heynevets/Smarker/Arduino/COEN315Assignment2/WebTrial/background.jpg

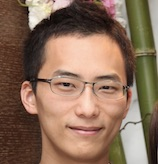
Arduino/COEN315Assignment2/WebTrial/background.jpg
