heynevets/Smarker/1_Deliverables/4_OutputSamples/2_Website/Screen Shot 2019-03-21 at 12.37.06 AM.png

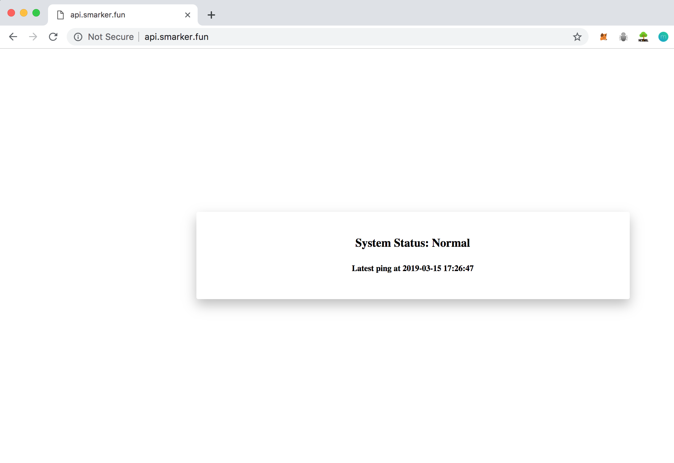
1_Deliverables/4_OutputSamples/2_Website/Screen Shot 2019-03-21 at 12.37.06 AM.png
