heynevets/Smarker/1_Deliverables/5_Reference/3_Propoganda/pamphlet.png

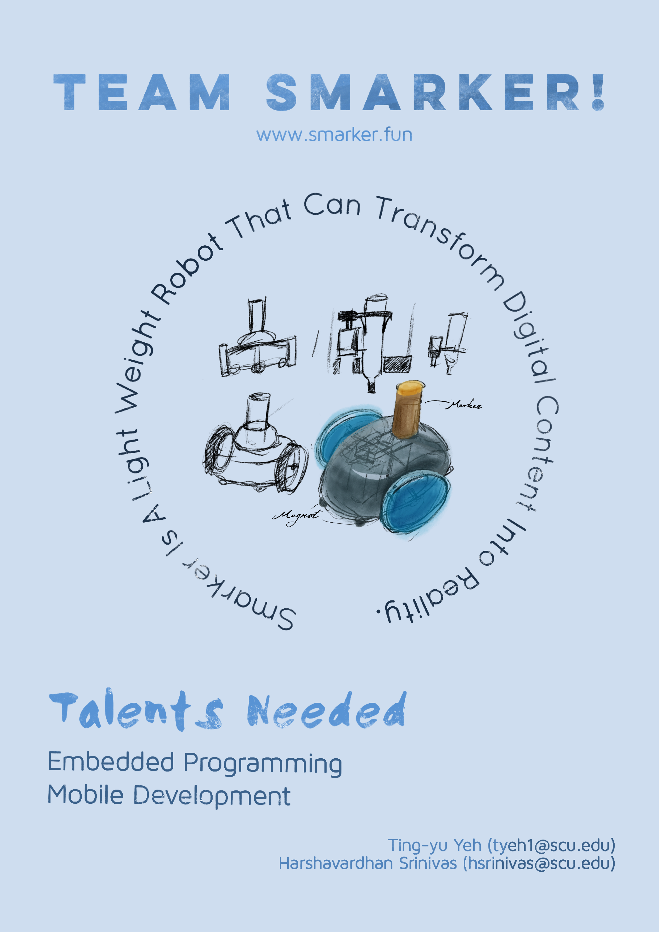
1_Deliverables/5_Reference/3_Propoganda/pamphlet.png
