heynevets/Smarker/Arduino/COEN315Assignment2/WebTrial/IMG_0066.png

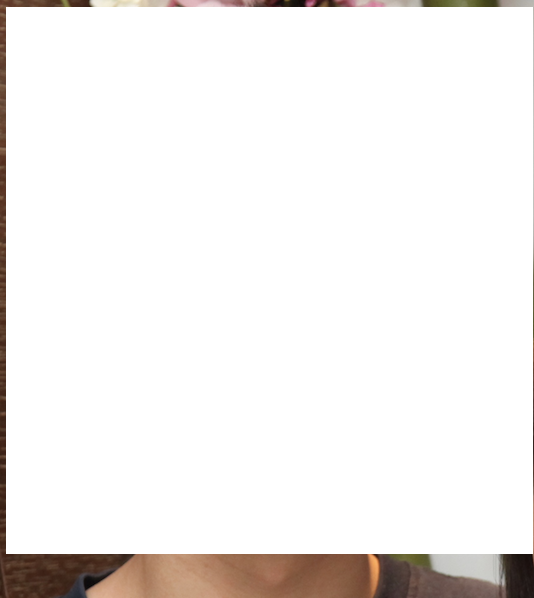
Arduino/COEN315Assignment2/WebTrial/IMG_0066.png
