heynevets/Smarker/1_Deliverables/5_Reference/1_CAD/WheelOuter.stl

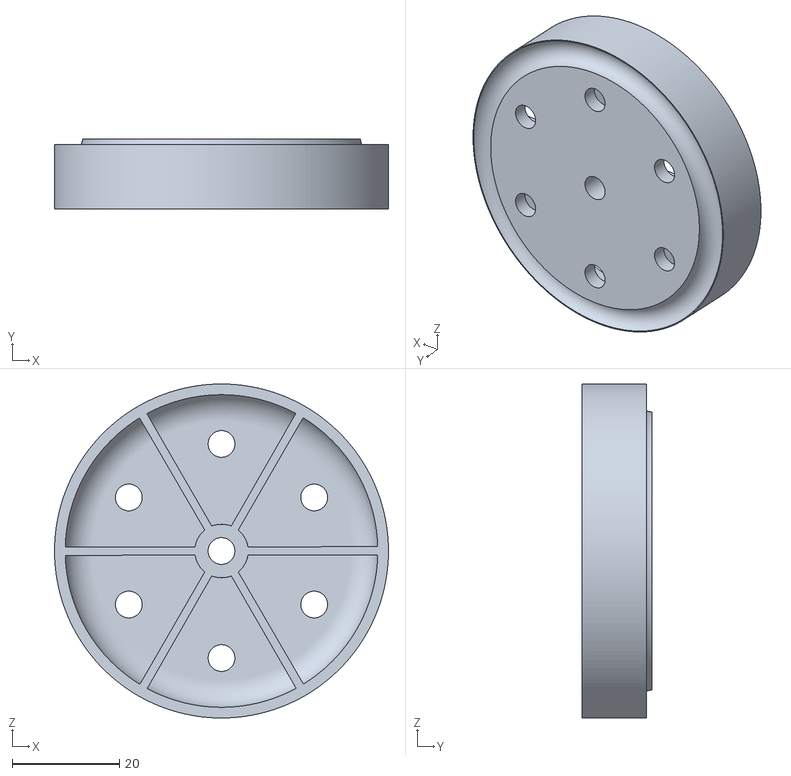
[picture p13: CAD file, 2019-03-21]
1_Deliverables/5_Reference/1_CAD/WheelOuter.stl
62.4 x 13.0 x 62.4
