heynevets/Smarker/1_Deliverables/5_Reference/1_CAD/markerHolder v3.stl

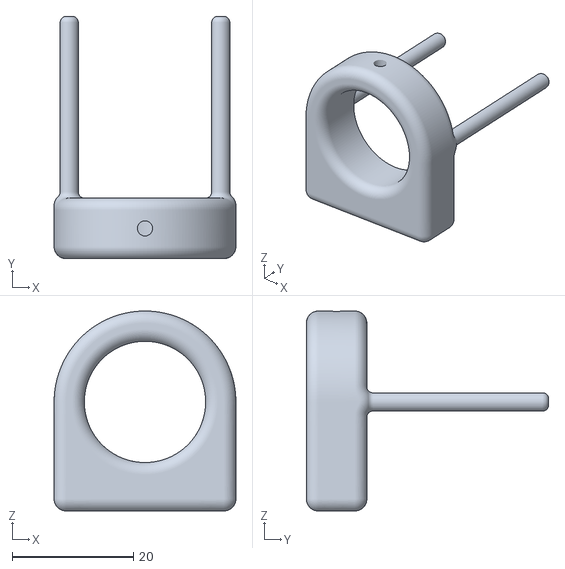
[picture p14: CAD file, 2019-03-21]
1_Deliverables/5_Reference/1_CAD/markerHolder v3.stl
30.0 x 40.0 x 33.0
