heynevets/Smarker/1_Deliverables/5_Reference/1_CAD/compressionHolder.stl

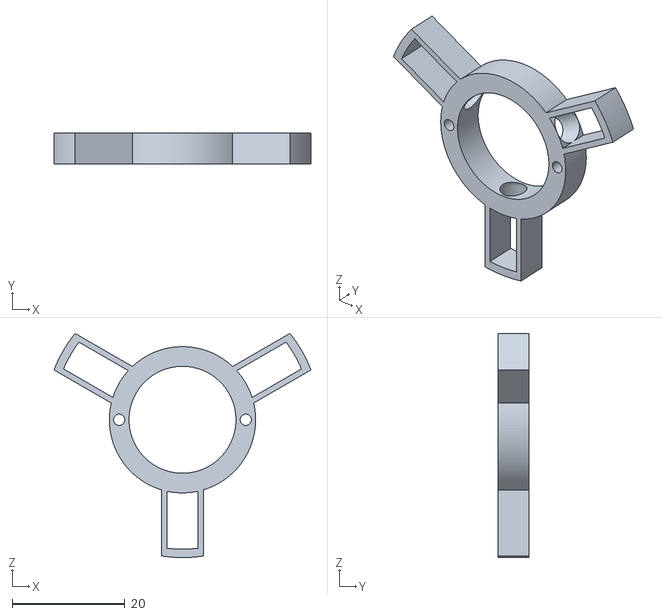
[picture p15: CAD file, 2019-03-21]
1_Deliverables/5_Reference/1_CAD/compressionHolder.stl
45.7 x 5.50 x 39.9
