heynevets/Smarker/1_Deliverables/5_Reference/1_CAD/bottomTopplate v11.stl

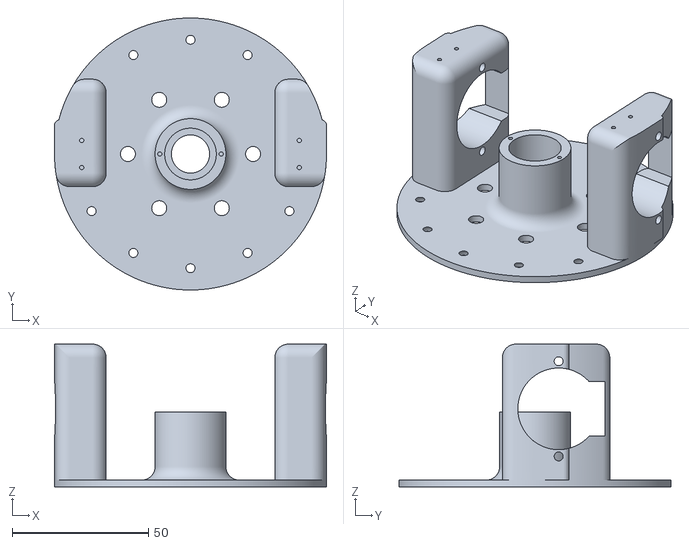
[picture p16: CAD file, 2019-03-21]
1_Deliverables/5_Reference/1_CAD/bottomTopplate v11.stl
100.0 x 100.0 x 52.5
