heynevets/Smarker/1_Deliverables/5_Reference/1_CAD/bottomBotplate v4.stl

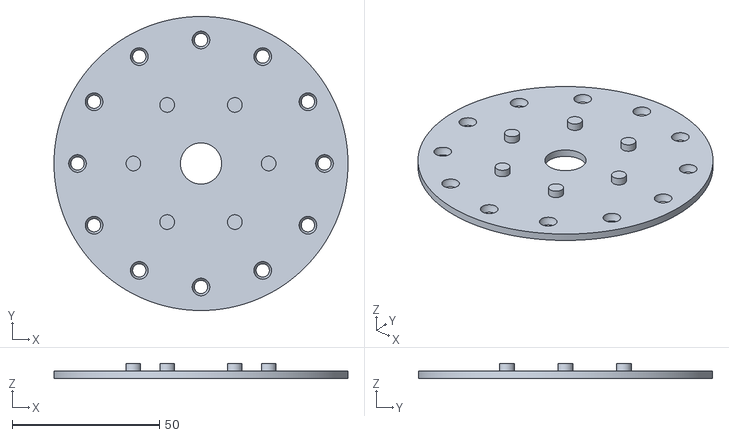
[picture p17: CAD file, 2019-03-21]
1_Deliverables/5_Reference/1_CAD/bottomBotplate v4.stl
100.0 x 100.0 x 5.00
