heynevets/Smarker/1_Deliverables/5_Reference/1_CAD/ServoPlate.stl

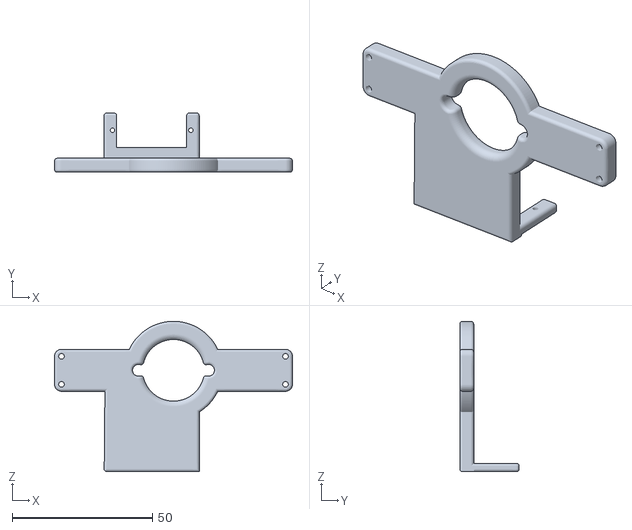
[picture p19: CAD file, 2019-03-21]
1_Deliverables/5_Reference/1_CAD/ServoPlate.stl
85.0 x 21.2 x 53.7
