heynevets/Smarker/1_Deliverables/5_Reference/1_CAD/WheelInner v3.stl

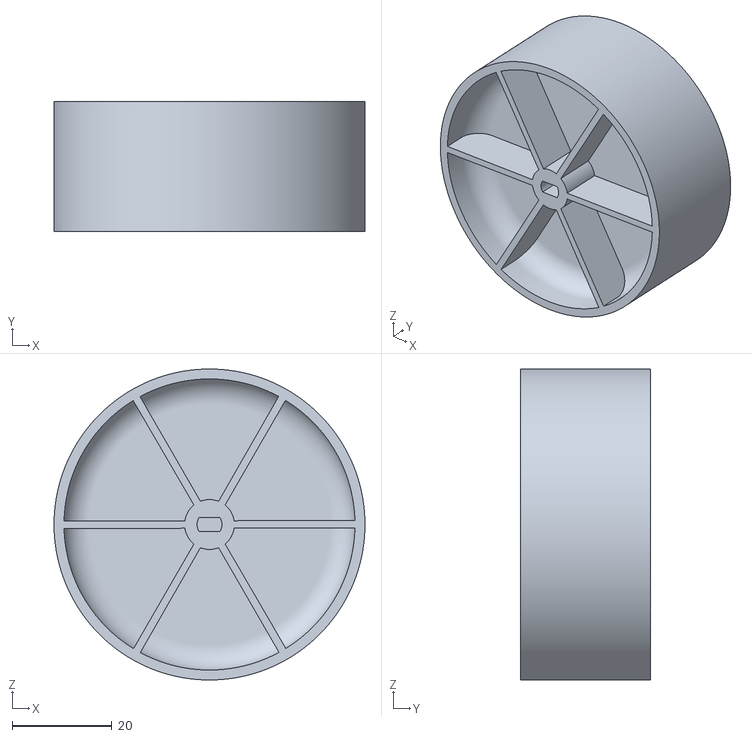
[picture p20: CAD file, 2019-03-21]
1_Deliverables/5_Reference/1_CAD/WheelInner v3.stl
62.4 x 26.0 x 62.4
