heynevets/Smarker/1_Deliverables/5_Reference/1_CAD/penHolder.stl

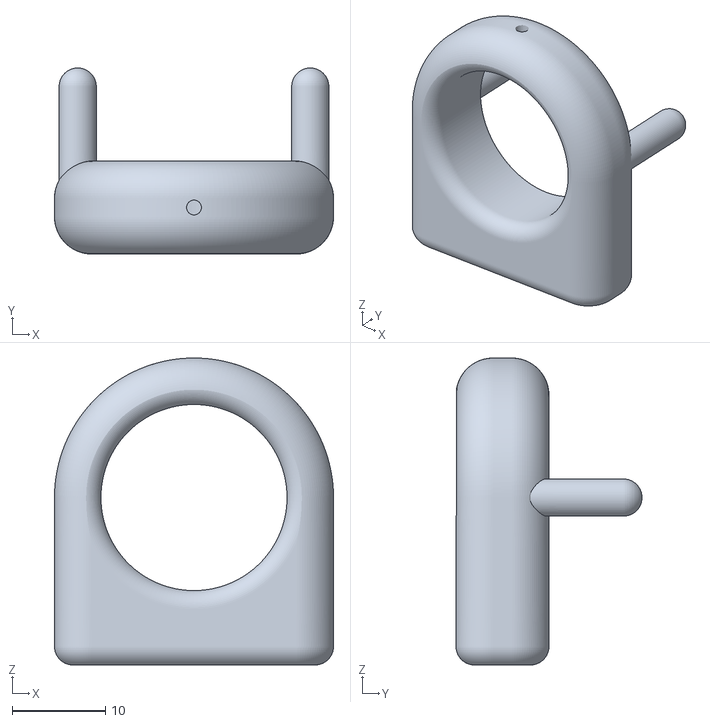
[picture p21: CAD file, 2019-03-21]
1_Deliverables/5_Reference/1_CAD/penHolder.stl
30.0 x 20.0 x 33.0
