heynevets/Smarker/Arduino/Harsha/Harsha.ino

#include "AccelStepper.h"
#include "MultiStepper.h"

#define FULLSTEP 4


// Motor pin definitions
#define motorPin11  32     // IN1 on the ULN2003 driver 1
#define motorPin12  33     // IN2 on the ULN2003 driver 1
#define motorPin13  25    // IN3 on the ULN2003 driver 1
#define motorPin14  26    // IN4 on the ULN2003 driver 1

#define motorPin21  5     // IN1 on the ULN2003 driver 1
#define motorPin22  18     // IN2 on the ULN2003 driver 1
#define motorPin23  19    // IN3 on the ULN2003 driver 1
#define motorPin24  21    // IN4 on the ULN2003 driver 1

#define numStepsPerRev 2048


// Initialize with pin sequence IN1-IN3-IN2-IN4 for using the AccelStepper with 28BYJ-48
AccelStepper stepper1(FULLSTEP, motorPin11, motorPin13, motorPin12, motorPin14);
AccelStepper stepper2(FULLSTEP, motorPin21, motorPin23, motorPin22, motorPin24);
MultiStepper steppers;
//
//void setup() {
//  stepper1.setMaxSpeed(1000.0);
//  stepper1.setAcceleration(100.0);
//  stepper1.setSpeed(2);
////  stepper1.moveTo(2000);
//
//  stepper2.setMaxSpeed(1000.0);
//  stepper2.setAcceleration(100.0);
//  stepper2.setSpeed(2);
////  stepper2.moveTo(-2000);
//  
//  ms.addStepper(stepper1);
//  ms.addStepper(stepper2);
//  long pos[2] = {2000, -2000}; 
//  ms.moveTo(pos);
//  
//  
//}
//
//void loop() {
//
//  //Change direction when the stepper reaches the target position
//  if (stepper1.distanceToGo() == 0) {
////    stepper1.moveTo(-stepper1.currentPosition());
////    stepper2.moveTo(-stepper2.currentPosition());
//    long pos[2] = {-stepper1.currentPosition(), -stepper2.currentPosition()}; 
//    ms.moveTo(pos);
//  }
////  stepper1.run();
////  stepper2.run();
//  ms.runSpeedToPosition();
//}
#define SIZE 243
long positions[SIZE][2] = {
{-1.45, 5.73}, 
{-6.49, 9.77}, 
{-1.88, 5.34}, 
{7.57, -3.95}, 
{7.99, -2.34}, 
{6.54, -1.93}, 
{-32.77, 33.33}, 
{-8.20, 9.82}, 
{3.26, 5.84}, 
{2.53, 5.67}, 
{5.78, 5.39}, 
{4.69, 4.26}, 
{5.11, 4.36}, 
{4.69, 4.44}, 
{2.32, 3.49}, 
{3.20, 3.58}, 
{3.39, 3.61}, 
{2.26, 3.97}, 
{1.54, 3.92}, 
{1.07, 4.75}, 
{-4.12, 7.77}, 
{115.20, -113.06}, 
{-15.31, 17.49}, 
{-5.07, 8.82}, 
{-2.85, 6.13}, 
{-2.57, 6.98}, 
{-4.02, 8.43}, 
{-1.09, 6.42}, 
{1.03, 3.50}, 
{0.46, 4.29}, 
{-0.87, 5.18}, 
{0.81, 2.72}, 
{1.39, 2.28}, 
{1.19, 2.72}, 
{1.20, 2.19}, 
{2.69, 0.97}, 
{4.05, 0.96}, 
{6.51, 3.00}, 
{7.27, 0.89}, 
{5.35, 2.08}, 
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
};

void setup() {
  Serial.begin(9600);
// new
  // Configure each stepper
  stepper1.setMaxSpeed(150);
//  stepper1.setAcceleration(10.0);
  stepper2.setMaxSpeed(150);
//  stepper2.setAcceleration(10.0);
//
  stepper1.setAcceleration(100.0);
  stepper1.setSpeed(10);

  stepper2.setAcceleration(100.0);
  stepper2.setSpeed(10);

//old
//  stepper1.setMaxSpeed(1000.0);
//  stepper1.setAcceleration(300.0);
//  stepper1.setSpeed(100);
//
//  stepper2.setMaxSpeed(1000.0);
//  stepper2.setAcceleration(300.0);
//  stepper2.setSpeed(100);

  


  // Then give them to MultiStepper to manage
  steppers.addStepper(stepper1);
  steppers.addStepper(stepper2);

  
  stepper1.setCurrentPosition(0);
  stepper2.setCurrentPosition(0);
}

void loop() {

  long position[2]; // = {stepper1.currentPosition() + positions[i][0], stepper2.currentPosition() + positions[i][1]};     
//  position[0] = 0;
//  position[1] = 0;
//  steppers.moveTo(position);
//  
//  steppers.runSpeedToPosition(); // Blocks until all are in position  
//  delay(1000);
  
  for (int i = 0; i < SIZE; i++) {
    
    position[0] = positions[i][0] * numStepsPerRev/66/PI + stepper1.currentPosition();
    position[1] = -positions[i][1] * numStepsPerRev/66/PI + stepper2.currentPosition();

    Serial.print("current I: ");
    Serial.println(i);
    Serial.print("delta 0: ");
    printDouble(positions[i][0], 3);
    Serial.print("delta 1: ");
    printDouble(positions[i][1], 3);
    Serial.println(">>>");
    
    Serial.print("current position 0:");
    printDouble(stepper1.currentPosition(), 3);
    Serial.print("target position 0:");
    printDouble(position[0], 3);

    Serial.print("current position 1:");
    printDouble(stepper2.currentPosition(), 3);
    Serial.print("target position 1:");
    printDouble(position[1], 3);

    Serial.println("^-----------------");
    
    

    
//    stepper1.moveTo(position[0]);
//    stepper2.moveTo(position[1]);
//    stepper1.run();
//    stepper2.run();
    
//    long pos[2] = {-stepper1.currentPosition(), -stepper2.currentPosition()}; 

    steppers.moveTo(position);
    steppers.runSpeedToPosition(); // Blocks until all are in position  
//    delay(1000);
  }

//  
//  
//  positions[0] = 1000;
//  positions[1] = -1000;
//  
//  
//  // Move to a different coordinate
//  positions[0] = -1000;
//  positions[1] = 1000;
//  steppers.moveTo(positions);
//  steppers.runSpeedToPosition(); // Blocks until all are in position
//  delay(1000);
}


void printDouble( double val, unsigned int precision){
// prints val with number of decimal places determine by precision
// NOTE: precision is 1 followed by the number of zeros for the desired number of decimial places
// example: printDouble( 3.1415, 100); // prints 3.14 (two decimal places)

   Serial.print (int(val));  //prints the int part
   Serial.print("."); // print the decimal point
   unsigned int frac;
   if(val >= 0)
       frac = (val - int(val)) * precision;
   else
       frac = (int(val)- val ) * precision;
   Serial.println(frac,DEC) ;
} 
